srobo-legacy/boards-motor-v4-hw/gerbers/README.txt

Company: Student Robotics
Contact: Rich Barlow
Email:   rbarlow@studentrobotics.org
Phone:   XXXXXXXXXXXX
--------------------------------------------------------------------------------
Board Reference:  mcv4
Board Issue:      b
--------------------------------------------------------------------------------
Board Details:
Bare Board Test:      Yes
Layers:               4
Copper Weight:        1oz (all layers)
Material:             1.6mm FR4
Solder Resist:        BLUE on 2 sides (130 off); RED on 2 sides (30 off)
Silk Screen:          WHITE on 2 sides
Notes:                Please tent vias with solder mask. Please do not pull-back
                      silk from around vias.
--------------------------------------------------------------------------------
Panel Details:
Please panelise as appropriate for in-house assembly. Please position breakout
pips as shown in the drawing 'mcv4b.breakout.png'. When the boards are removed
from the panel it is required that the waste material on the board remains
within the profile of a square corner, as shown in the drawing.
--------------------------------------------------------------------------------
Stack up:
top
group2
group3
bottom
--------------------------------------------------------------------------------
Included Files:

Board:
mcv4b.top.gbr            - Top Copper Layer (Layer 1)
mcv4b.group2.gbr         - First Inner Layer (Layer 2)
mcv4b.group3.gbr         - Second Inner Layer (Layer 3)
mcv4b.bottom.gbr         - Bottom Copper Layer (Layer 4)
mcv4b.topmask.gbr        - Solder Mask Top
mcv4b.bottommask.gbr     - Solder Mask Bottom
mcv4b.toppaste.gbr       - Solder Paste Top
mcv4b.topsilk.gbr        - Silk Screen Top
mcv4b.bottomsilk.gbr     - Silk Screen Bottom
mcv4b.outline.gbr        - Board Outline
mcv4b.plated-drill.cnc   - Plated Hole Drill Information
mcv4b.unplated-drill.cnc - Unplated Hole Drill Information
mcv4b.breakout.png       - Drawing showing positioning of breakout pips

Assembly:
mcv4b.assembly.gbr       - Assembly drawing showing component locations
mcv4b.xy.csv             - XY Placement Data
--------------------------------------------------------------------------------
If there are any problems please contact Rich Barlow using the details at
the top of this file.
