srobo-legacy/boards-motor-v4-hw/gerbers/mcv4b.breakout.png

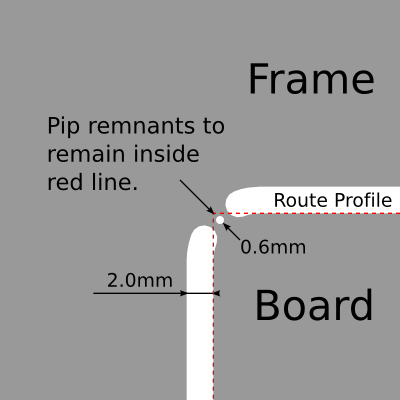
gerbers/mcv4b.breakout.png
