srobo-legacy/boards-motor-v4-hw/bom.xls

Line No. | Internal Part Number | Qty | Value/Description | Package | Distributor | Distributor Order Number | Manufacturer | Manufacturer P/N | Reference Designators
1 | sr-c-100n-0402-16v | 15 | 100n capacitor 0402 16V X7R | 0402 | farnell | 1758896RL | any/open |  | C5, C6, C7, C8, C9, C10, C11, C13, C14, C15, C18, C20, C21, C27, C28
2 | sr-c-100n-0603-50v | 6 | 100n capacitor 0603 50V X7R | 0603 | farnell | 1759122RL | any/open |  | C31, C32, C33, C35, C44, C48
3 | sr-c-10n-0402-25v | 1 | 10n capacitor 0402 25V X7R | 0402 | farnell | 1758924RL | any/open |  | C17
4 | sr-c-10u-1206-16v | 2 | 10u capacitor 1206 16V X7R | 1206 | farnell | 2070502RL | any/open |  | C34, C36
5 | sr-c-1n-0402-50v | 2 | 1n capacitor 0402 50V X7R | 0402 | farnell | 1758991RL | any/open |  | C24, C25
6 | sr-c-1u-0603-16v | 2 | 1u capacitor 0603 16V X7R | 0603 | farnell | 2112839RL | any/open |  | C16, C22
7 | sr-c-220n-0402-16v | 1 | 220n capacitor 0402 16V X5R | 0402 | farnell | 1759389RL | any/open |  | C50
8 | sr-c-22u-0805-6v3 | 2 | 22u capacitor 0805 6.3V X5R | 0805 | farnell | 1867955RL | any/open |  | C4, C52
9 | sr-c-27p-0402-50v | 2 | 27p capacitor 0402 50V C0G/NP0 | 0402 | farnell | 1414584RL | any/open |  | C29, C30
10 | sr-c-2u2-1206-50v | 2 | 2u2 capacitor 1206 50V X7R | 1206 | farnell | 1797017RL | any/open |  | C3, C23
11 | sr-c-33n-0402-25v | 8 | 33n capacitor 0402 25V X7R | 0402 | farnell | 1865445RL | any/open |  | C41, C42, C43, C45, C46, C47, C49, C51
12 | sr-c-470n-0603-25v | 1 | 470n capacitor 0603 25V X7R | 0603 | farnell | 1856365RL | any/open |  | C26
13 | sr-c-47n-0603-50v | 2 | 47n capacitor 0603 50V X7R | 0603 | farnell | 1759116RL | any/open |  | C2, C19
14 | sr-c-4u7-0805-10v | 2 | 4.7u capacitor 0805 10V X7R | 0805 | farnell | 1833814RL | any/open |  | C1, C12
15 | sr-c-pcf1c221mcl1gs | 4 | 220u capacitor smt electrolytic 16V 3.9A ripple | smt_electrolytic_cap | mouser | 647-PCF1C221MCL1GS | Nichicon | PCF1C221MCL1GS | C37, C38, C39, C40
16 | sr-cm-20a-170r | 1 | 20A through-hole cm choke 170R at 100MHz | through_hole | mouser | 875-CM3440Z171B-10 | Laird Technologies | CM3440Z171B-10 | L11
17 | sr-cn-camcon2w | 1 | CTB9550/2 – Pluggable terminal block 2way 7.5mm pitch male horiz | through_hole | farnell | 3882391 | Camden Boss | CTB9550/2 | J5
18 | sr-cn-camcon2w-5mm | 2 | CTB9350/2A – Pluggable terminal block 2way 5mm pitch male horiz | through_hole | farnell | 3882093 | Camden Boss | CTB9350/2A | J6, J7
19 | sr-cn-header2x4-std | 1 | 2x4 through-hole 2.54mm header – 6mm pin length | through_hole | farnell | 1593441 | any/open |  | J2
20 | sr-cn-header2x5-1.27mm | 1 | 2x5 through-hole 1.27mm header – 3mm pin length | through_hole | farnell | 1577743 | any/open |  | J4
21 | sr-cn-minicamcon4w | 1 | CTB93HE/4 – Pluggable terminal block 4way 3.81mm pitch male horiz | through_hole | farnell | 1717073 | Camden Boss | CTB93HE/4 | J3
22 | sr-cn-usb-micro-b | 1 | Micro USB B connector for top mounting | through_hole | digikey | 609-4048-6-ND | FCI | 10103592-0001LF | J1
23 | sr-d-82400102 | 1 | Wurth 82400102 dual TVS diode array | sot23-6 | farnell | 1825875RL | Wurth Elektronik | 82400102 | VR1
24 | sr-d-bat754a | 1 | Schottky diode dual | sot23 | farnell | 1081204RL | NXP | BAT754A | D15
25 | sr-d-bat754c | 2 | schottky diode dual | sot23 | farnell | 1081205RL | NXP | BAT754C | D1, D13
26 | sr-d-bat754s | 5 | schottky diode dual | sot23 | farnell | 1081206RL | NXP | BAT754S | D4, D6, D7, D8, D9
27 | sr-d-bzx384c3v3 | 1 | zener diode 3.3V 5% | sod323 | farnell | 8735646RL | NXP | BZX384-C3V3 | D5
28 | sr-d-gsot05c | 1 | 5V unidirectional dual TVS diode 480W common anode | sot23 | mouser | 78-GSOT05C | Vishay | GSOT05C-GS08 | D10
29 | sr-d-gsot24c | 2 | 24V unidirectional dual TVS diode 325W common anode | sot23 | mouser | 78-GSOT24C | Vishay | GSOT24C-GS08 | D11, D12
30 | sr-d-mmsz4689t1g | 1 | zener diode 5.1V 500mW | sod123 | farnell | 1459121RL | On Semiconductor | MMSZ4689T1G | D2
31 | sr-d-smaj15ca | 1 | 15V bidirectional TVS diode 400W | do-214ac(sma) | farnell | 9802789RL | STMicroelectronics | SMAJ15CA-TR | D3
32 | sr-fb-200m-1k-0402 | 10 | 200mA 1k @ 100MHz 0402 | 0402 | farnell | 1669673RL | any/open |  | L1, L2, L3, L4, L5, L6, L7, L8, L9, L10
33 | sr-fet-n-irfh5301 | 1 | IRFH5301PBF n-channel mosfet 35A | pqfn8 | farnell | 1782047 | International Rectifier | IRFH5301TR2PBF | Q2
34 | sr-fuse-r50-1206 | 1 | 50mA 60V resettable fuse | 1206 | digikey | 507-1476-1-ND | Bel Fuse Inc | 0ZCA0005FF2E | F1
35 | sr-ic-adum3211arz | 1 | ADUM3211ARZ 2.5kV 10Mbps dual bi-directional isolator | soic8 | farnell | 2313635 | Analog Devices | ADUM3211ARZ | U2
36 | sr-ic-ft232rq | 1 | FT232RQ USB to UART | qfn32 | farnell | 1146033RL | FTDI | FT232RQ | U3
37 | sr-ic-lmr14203 | 1 | LMR14203XMK step-down DC/DC converter 42V 0.3A | sot23-6 | farnell | 2064680 | TI | LMR14203XMKE/NOPB | U1
38 | sr-ic-stm32f100r8 | 1 | STM32F100R8 32bit mcu 64k flash 8k ram | lqfp64 | farnell | 1838508 | STMicroelectronics | STM32F100R8T6B | U4
39 | sr-ic-vnh5019 | 2 | VNH5019A-E 30A H-Bridge | power-so30 | verical | VNH5019A-E | STMicroelectronics | VNH5019A-E | U5, U6
40 | sr-l-68u-900ma | 1 | 68u 0.9A smt inductor | smt_inductor | farnell | 2061657 | Bourns | SRN6045-680M | L12
41 | sr-led-blue-0805 | 2 | LED 0805 Blue | 0805 | farnell | 2217974 | Kingbright | KP-2012QBC-D | DS3, DS5
42 | sr-led-green-0805 | 1 | LED 0805 Green | 0805 | farnell | 1318243RL | Kingbright | KP-2012SGC | DS1
43 | sr-led-red-0805 | 3 | LED 0805 Red | 0805 | farnell | 8529949RL | Kingbright | KP-2012EC | DS2, DS4, DS6
44 | sr-led-redblue-dual | 2 | Dual LED Red/Blue | 0805_split | farnell | 1686083RL | Kingbright | KPHBM-2012PBASURKC | DS8, DS9
45 | sr-led-redgreen-0805 | 1 | Bi-Colour LED Red/Green 0805 | 0805 | farnell | 2079908 | Kingbright | KPB-2012SURKCGKC | DS7
46 | sr-npn-bc846b | 2 | BC846B NPN BJT 65V 100mA | sot23 | farnell | 1081229RL | NXP | BC846B | Q1, Q3
47 | sr-r-100-0402 | 1 | 100 0402 chip resistor (63mW) 1% | 0402 | farnell | 2072515 | any/open |  | R17
48 | sr-r-1000k-0402 | 1 | 1M 0402 chip resistor 1% | 0402 | farnell | 2072521 | any/open |  | R9
49 | sr-r-10k | 2 | 10k 0603 chip resistor 1% | 0603 | farnell | 9330399RL | any/open |  | R35, R51
50 | sr-r-10k-0402 | 14 | 10k 0402 chip resistor 1% | 0402 | farnell | 2072517 | any/open |  | R10, R13, R16, R18, R19, R20, R32, R38, R48, R54, R57, R58, R59, R60
51 | sr-r-1k-0402 | 10 | 1k 0402 chip resistor 1% | 0402 | farnell | 2072516 | any/open |  | R27, R28, R30, R31, R36, R43, R44, R46, R47, R52
52 | sr-r-1k-1206 | 3 | 1k 1206 chip resistor 1% | 1206 | farnell | 2073877 | any/open |  | R21, R37, R53
53 | sr-r-1k1-0402 | 7 | 1k1 0402 chip resistor 1% | 0402 | farnell | 2072548 | any/open |  | R23, R26, R34, R39, R42, R50, R55
54 | sr-r-330-0402 | 6 | 330 0402 chip resistor 1% | 0402 | farnell | 2072927 | any/open |  | R1, R4, R6, R7, R8, R12
55 | sr-r-33k2-0402 | 1 | 33k2 0402 chip resistor 1% | 0402 | farnell | 2072936 | any/open |  | R56
56 | sr-r-4k3-0402 | 5 | 4k3 0402 chip resistor 1% | 0402 | farnell | 2073030 | any/open |  | R22, R25, R33, R41, R49
57 | sr-r-4k7-0402 | 7 | 4k7 0402 chip resistor 1% | 0402 | farnell | 2073064 | any/open |  | R5, R14, R15, R24, R29, R40, R45
58 | sr-sw-button-ra | 1 | FSMRA2JH Right angle tactile button | through_hole | farnell | 1555987 | TE Connectivity | FSMRA2JH | S1
59 | sr-xtal-abmm2-8.000mhz-e2-t | 1 | 8MHz Crystal 20ppm | smt_crystal | farnell | 1611803RL | ABRACON | ABMM2-8.000MHZ-E2-T | Y1
