srobo-legacy/boards-motor-v4-hw/case.dxf

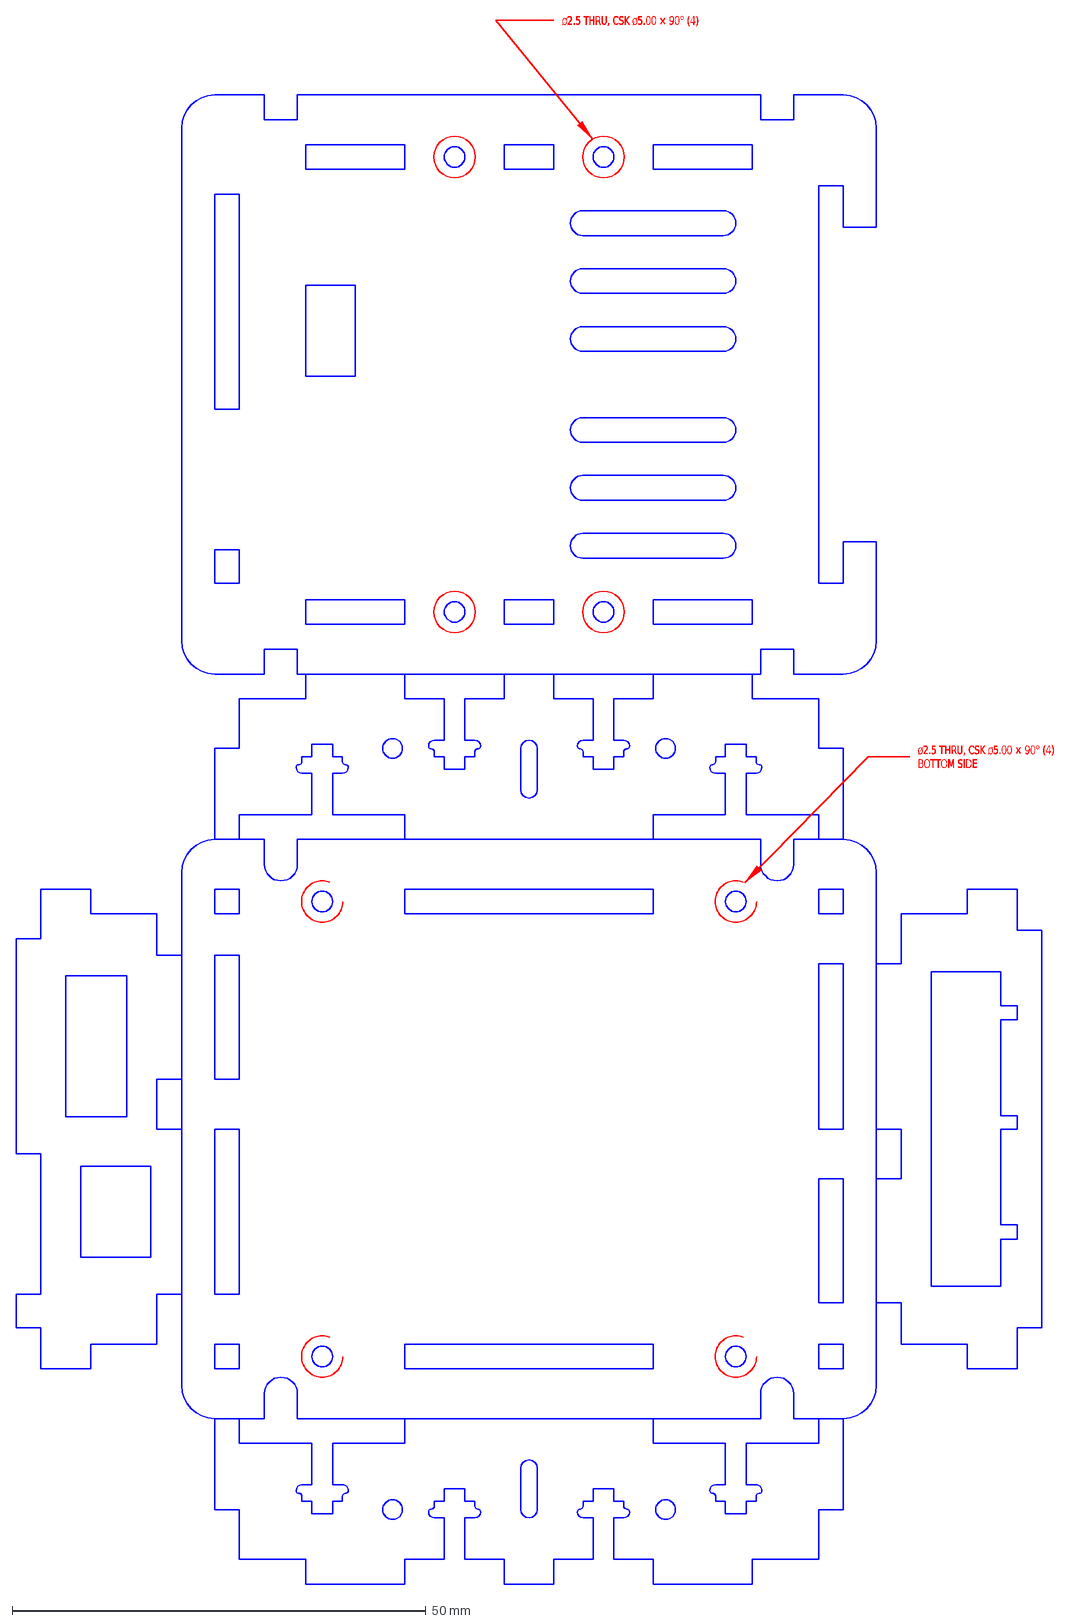
[picture p2: CAD file, 2013-08-05]
case.dxf
ø2.5\~THRU,\~CSK\~ø5.00\~×\~90°\~(4) BOTTOM\~SIDE
ø2.5\~THRU,\~CSK\~ø5.00\~×\~90°\~(4)
