srobo-legacy/boards-motor-v4-hw/(list of files, drawings)

Other design files:
motor.pcb
pcb_silk/silk.pcb
