srobo-legacy/boards-motor-v4-hw/(commit log)

2013-02-03 Begin the development of the USB motor board
    [motor-logic.sch]
2013-02-03 Add a title and 'power' schematic
    [motor-power.sch, motor-title.sch]
2013-02-03 Add makefile to generate pdf/bom
    This is the same makefile as used by the previous motor board design,
    however it's had the gsch2pcb stuff removed as I'm going to use the PCB
    'import' feature to forward annotate.
2013-02-04 Add block diagram to schematic
    [motor-title.sch]
2013-02-04 Shift the schematic titles
    The word 'Power' was overlapping the border when exported.
    [motor-logic.sch, motor-power.sch, motor-title.sch]
2013-02-17 Draw most of the interface side
    [motor-logic.sch]
2013-02-18 Correct values of UART filter caps
    [motor-logic.sch]
2013-02-18 Add a load of test points to the interface side
    [motor-logic.sch]
2013-02-19 Add filter cap to FT232 reset pin
    [motor-logic.sch]
2013-02-19 Shuffle things around, no electrical change
    [motor-logic.sch]
2013-02-19 Add zener diode to IFACE_VCC rail
    [motor-logic.sch]
2013-02-19 Add note about USB data line routing
    [motor-logic.sch]
2013-02-19 Add JTAG connector
    [motor-logic.sch]
2013-02-19 Add STM32 crystal
    [motor-logic.sch]
2013-02-21 Add 3V3 reg
    [motor-logic.sch]
2013-02-22 Add cap and test point to uC reset line
    [motor-logic.sch]
2013-02-26 Add boot/reset button circuit
    Pressing this button puts the uC into its ROM bootloader, allowing a
    brand-new or 'bricked' board to be flashed over its UART.
    The circuit pulls the BOOT0 line high and sends a 1ms reset pulse to the
    uC.
    [motor-logic.sch]
2013-02-27 Correct BOOT/nRESET circuit
    The output of the circuit was wired up to BOOT0 instead of nRESET as it
    should have been. BOOT0 is taken directly from the button.
    [motor-logic.sch]
2013-02-27 Add graphical representaton of the isolation barrier
    [motor-logic.sch]
2013-02-27 Connect up uC UART to isolator
    [motor-logic.sch]
2013-02-28 Draw a big chunk of the power schematic
    [motor-power.sch]
2013-02-28 Add most of the interface circuitry between the uC and H-Bridges
    [motor-logic.sch, motor-power.sch]
2013-03-01 Add current sense filters
    [motor-power.sch]
2013-03-01 Add output voltage feedback dividers
    [motor-power.sch]
2013-03-01 Add clamping diodes to the voltage feedback lines
    [motor-power.sch]
2013-03-01 Shuffle some things about, no electrical change
    [motor-power.sch]
2013-03-01 Add 12V sense divider
    [motor-power.sch]
2013-03-01 Add direction/power LEDs to the outputs
    [motor-power.sch]
2013-03-01 Add power side power LED
    [motor-power.sch]
2013-03-01 Add some filtering to the outputs
    The resistor ensures there's always a small amount of load even with no
    motor connected. The cap provides a small amount of differential
    filtering.
    [motor-power.sch]
2013-03-01 Add TVS diode to the main power input
    [motor-power.sch]
2013-03-01 Add an LED to indicate incorrect power polarity
    [motor-power.sch]
2013-03-01 Add isolation bypass resistors
    [motor-logic.sch]
2013-03-01 Add loads of test points
    [motor-logic.sch, motor-power.sch]
2013-03-02 Wire up H-bridges to uC
    [motor-logic.sch]
2013-03-02 Add four controllable LEDs
    [motor-logic.sch]
2013-03-03 Add expansion header
    [motor-logic.sch]
2013-03-03 Swap expansion header symbol for a double-sided variant
    This makes it more clear how the signals are laid out. I've also
    rearranged the signals so that the ground pin shields the signal lines
    from the potentially noisy 12V line.
    [motor-logic.sch]
2013-03-03 Add some filtering to the expansion header power lines
    [motor-logic.sch]
2013-03-03 Assign actual SR part codes to all the 100n caps
    [motor-logic.sch, motor-power.sch]
2013-03-03 Add values to the 1uF caps
    [motor-logic.sch]
2013-03-03 Add values to 10uF caps
    [motor-logic.sch, motor-power.sch]
2013-03-03 Add values to the 33nF caps
    [motor-power.sch]
2013-03-03 Assign values to the 4.7uF caps
    [motor-logic.sch]
2013-03-03 Assign values to the 10nF and 1nF caps
    [motor-logic.sch]
2013-03-03 Add value to USB shield cap
    [motor-logic.sch]
2013-03-03 Add value to 470nF cap
    [motor-logic.sch]
2013-03-03 Add values to main bulk decoupling caps
    [motor-power.sch]
2013-03-03 Add value to common mode choke
    [motor-power.sch]
2013-03-03 Add value to crystal and crystal loading caps
    [motor-logic.sch]
2013-03-05 Add values to the FT232 and the isolator
    [motor-logic.sch]
2013-03-05 Add value to STM32
    [motor-logic.sch]
2013-03-05 Add values to H-Bridges
    [motor-power.sch]
2013-03-05 Add value to 3V3 reg
    [motor-logic.sch]
2013-03-05 Add value to USB protection device
    [motor-logic.sch]
2013-03-05 Add value to reverse polarity protection fet
    [motor-power.sch]
2013-03-05 Assign values to the off-board connectors
    [motor-logic.sch, motor-power.sch]
2013-03-05 Add value to reset BJT
    [motor-logic.sch]
2013-03-05 Add value to reset/boot button
    [motor-logic.sch]
2013-03-06 Add values to all resistors
    Values that don't have a chip size in them are 0603
    [motor-logic.sch, motor-power.sch]
2013-03-07 Assign values to dual diodes
    [motor-logic.sch, motor-power.sch]
2013-03-07 Add values to ferrite beads
    [motor-logic.sch]
2013-03-07 Add value to zener diode
    [motor-logic.sch]
2013-03-07 Add values to JTAG and EXP headers
    [motor-logic.sch]
2013-03-07 Add value to polyfuse
    [motor-logic.sch]
2013-03-07 Add value to main TVS diode
    [motor-power.sch]
2013-03-07 Add values to LEDs
    [motor-logic.sch, motor-power.sch]
2013-03-07 Add 3V3 zener to 3V3 rail
    There are quite a few clamping diodes that clamp to the 3V3 rail. The
    zener is there to ensure that there's somewhere for the clamped energy
    to go.
    [motor-power.sch]
2013-03-08 Assign reference designators
    [motor-logic.sch, motor-power.sch]
2013-03-08 Set value of test points and make values lower case
    [motor-logic.sch, motor-power.sch]
2013-03-08 Remove two superfluous test points
    [motor-logic.sch, motor-power.sch]
2013-03-13 Add more notes to the schematic
    [motor-logic.sch, motor-power.sch]
2013-04-06 Add TVS diodes to all external non-power connections
    These are the terminals which are going to experience ESD. The power
    line on the serial connector is already protected by the zener on the
    interface power rail. The main power connector already has a
    bidirectional TVS diode on it.
    [motor-logic.sch, motor-power.sch]
2013-04-07 Change linear 3V3 reg to SMPS
    The LDO would have always run warm and it wouldn't be able to handle 24V
    operation. The SMPS solution is ~80p more, can handle 24V operation and
    can output up to 200mA.
    [motor-logic.sch]
2013-04-07 Increase the voltage rating of a few caps
    To make supporting 24V easier - these caps won't need swapping.
    [motor-logic.sch]
2013-04-07 Change some 1k resistors to 1206
    These resistors need to dissipate a fair bit of power. The 2k2 resistors
    that'll go into their place for 24V operation will need to dissipate
    even more.
    [motor-power.sch]
2013-04-07 Add a table outlining what components to use for 24V
    [motor-title.sch]
2013-04-07 Update comment about isolation bridge components
    Also add a dummy diode to remove the need to power the interface side
    when not using isolation and using the serial interface.
    [motor-logic.sch]
2013-04-09 Add some stuff to protect against 24V reverse polarity
    The charge pump section of the VNH5019 can only handle -16V, so would be
    destroyed by -24V applied to the board. The new bit of circuitry ensures
    that the reverse polarity FET is off when reverse polarity is applied,
    while ensuring that no negative voltage is applied to the VNH5019 charge
    pump at all.
    [motor-power.sch]
2013-04-09 Add some test points to the reverse polarity stuff
    [motor-power.sch]
2013-04-09 More resistors to change for 24V
    The output voltage measurement potential divider resistors also need to
    change value for 24V operation.
    [motor-title.sch]
2013-04-20 Add footprint 'pkg' submodule
2013-04-27 Update schematic for modified crystal symbol
    The crystal has four pins, two of them are the can and should be
    connected to ground.
    [motor-logic.sch]
2013-05-04 Remove superfluous diode
    The body diode in the reverse polarity protection FET (Q2) already
    performs the function of the removed diode. The diode was only there to
    provide power to the VBATT pins of the VNH5019s. We don't actually need
    the functionality of the VBATT pins any more (their function is to
    handle large negative voltages without damage). To ensure we're
    operating the VNH5019s within spec the VBATT pins should still be
    powered, but there should be no problem just powering them from the same
    rail as the VCC lines.
    [motor-power.sch]
2013-05-06 Assign footprints to all components
    [motor-logic.sch, motor-power.sch]
2013-05-06 Correct a few footprint errors and add test point fp
    [motor-logic.sch, motor-power.sch]
2013-05-06 Add pcb settings file to force package search path
2013-05-11 Add PCB layout file, with configured DRC and layers
    [motor.pcb]
2013-05-12 Place the power stuff and the USB stuff
    [motor.pcb]
2013-05-12 Correct net names on inter-sheet symbols
    [motor-power.sch]
2013-05-12 Swap status LED/resistors around
    The traces to these LEDs are going to be running near the power stuff.
    So it makes more sense for the potentially noisey lines to be connected
    to the uC through the resistors.
    [motor-logic.sch]
2013-05-12 Finish placing components on PCB layout
    [motor.pcb]
2013-05-12 Reduce the PCB canvas size
    [motor.pcb]
2013-05-12 Remove the footprint name from the description field
    PCB doesn't have the ability to not output a bit of text for each
    footprint while still outputting the rest of the silk. It does allow you
    to select between three different things, so I've set one of these to be
    empty for all footprints and told it to output that.
    The board is too dense to fit the reference designators in. I will place
    them in the middle of the components for as assembly aid.
    [motor.pcb]
2013-05-12 Revert "Remove the footprint name from the description field"
    Turns out this breaks the import schematics things quite
    catastrophically. It uses the 'description' field to track where each
    instantiated footprint came from. This is fair enough, but it shouldn't
    segfault when there's an empty description ;) I'll have to find another
    solution for not showing any text later on.
    This reverts commit 5a5fa36101c22009639dc5acd1d13cc55bf431a4.
    [motor.pcb]
2013-05-12 Swap the output pins around
    So that they align on the layout
    [motor-power.sch, motor.pcb]
2013-05-12 Shuffle some bits and bobs around
    [motor.pcb]
2013-05-12 Alter how the isolation bypass is performed
    This is quite horrible and hacky at the moment, but the bypass pads are
    included in the SOIC8 footprint itself. This means that the symbols
    shown on the schematic are not functional and do not have footprints in
    the layout. Unfortunately I can't find a way of telling PCB this, so
    I've just disconnected them in the schematic for now.
    [motor-logic.sch, motor.pcb]
2013-05-13 Route the main power traces
    [motor.pcb]
2013-05-18 Swap USB TVS diode array
    The previous one was just too small. This one is more sane and possibly
    cheaper if bought direct from Wurth.
    [motor-logic.sch]
2013-05-19 Routing
    Swap the MISO/MOSI lines around on the expansion header to make routing
    easier.
    [motor-logic.sch, motor.pcb]
2013-05-20 Routing (Finished!)
    [motor.pcb]
2013-05-20 Add another GND test point
    This one is right next to the microcontroller analogue ground pin
    [motor-logic.sch, motor.pcb]
2013-05-20 Change most 0.25mm traces to 0.2mm
    [motor.pcb]
2013-05-20 Add interface GND plane to bottom layer
    [motor.pcb]
2013-05-20 Add ground plane on bottom layer
    [motor.pcb]
2013-05-20 Position refdeses
    [motor.pcb]
2013-05-21 Produce red photo-realistic PCB images
    Also exclude the reference designators from the top layer.
2013-05-24 Move some traces in from the edge
    [motor.pcb]
2013-05-24 Increase the annular ring around some pins
    [motor.pcb]
2013-05-26 Add some fancy silk to the bottom side
    [motor.pcb, silk.pcb]
2013-05-26 Add some more interface labels
    Also moved some test point identifiers away from a mounting hole.
    [motor.pcb]
2013-05-27 Remove 'both' photo pcb png in make clean target
2013-05-27 Add Rev A gerbers
    [motor-v4a.bottom.gbr, motor-v4a.bottommask.gbr, motor-v4a.bottomsilk.gbr, motor-v4a.fab.gbr, motor-v4a.inner1.gbr, motor-v4a.inner2.gbr, motor-v4a.outline.gbr, motor-v4a.top.gbr]
2013-06-10 Correct position of R29/R30 refdes on PCB layout
    These were the wrong way around.
    [motor.pcb]
2013-06-21 Allow some random changes by PCB
    For some reason PCB wants to change some units in the file even though
    I've not changed anything in the layout. The layout is identical to the
    previous commit.
    [motor.pcb]
2013-06-21 Flip the main power LED
    It was backwards. I want green to be normal and red to indicate a
    problem.
    [motor-power.sch, motor.pcb]
2013-06-21 Shuffle traces around the push button
    A couple of traces underneath the push button were a little too close
    for comfort to the metal frame where it touches the PCB.
    [motor.pcb]
2013-06-27 Switch to a bigger uC
    The R6 and R8 are pin compatible. The R8 has 64k of flash and 8k of RAM.
    The main reason for switching is that the R8 has TIM4, which means that
    both TIM3 and TIM4 will be exposed on the expansion header. This will
    allow for really easy quadrature encoder based feedback for both
    channels. Even if we don't take advantage of this straight away, it'll
    be really annoying in the future if we can't do it because of a weedy
    micro.
    [motor-logic.sch]
2013-06-27 Correct the uC value on the power symbol
    [motor-logic.sch]
2013-06-27 Add assembler compatible BOM
    [bom.xls]
2013-06-29 Update distributors for out of stock components
    [bom.xls]
2013-06-29 Modify board silk for Rev B
    [motor.pcb, silk.pcb]
2013-06-29 Add Rev B gerbers
    [mcv4b.assembly.gbr, mcv4b.bottom.gbr, mcv4b.bottommask.gbr, mcv4b.bottomsilk.gbr, mcv4b.group2.gbr, mcv4b.group3.gbr, mcv4b.outline.gbr, mcv4b.top.gbr]
2013-06-29 Add revision letter to schematics
    [motor-logic.sch, motor-power.sch, motor-title.sch]
2013-06-30 Rename the placement CSV to prevent windows confusion
    Windows probably won't like a '.xy' file. Also remove the # comments
    from the top of the file and use mm instead of mils.
    [mcv4b.xy.csv]
2013-07-13 Begin the case design
    [case.dxf]
2013-07-13 Finish case design
    [case.dxf]
2013-07-14 Change case line colour and thickness
    Razorlab needs lines to be very thin (for unknown reasons) and blue
    lines are used to indicate cut lines.
    [case.dxf]
2013-07-14 case: Fix the size/position of the screw holes
    These were all slightly the wrong diameter and positioned in weird
    off-grid positions.
    [case.dxf]
2013-07-14 case: Add layer showing countersink on screw holes
    [case.dxf]
2013-07-15 Update the BOM with the final suppliers
    Farnell now sell more things, and they're cheaper than elsewhere. Also
    less Digikey, which is always a good thing.
    [bom.xls]
2013-07-30 Remove 'Notes' column from the BOM
    [bom.xls]
2013-08-05 Add camcon plug notches to case design
    [case.dxf]
2013-12-27 Correct file names in schematic title blocks
    [motor-power.sch, motor-title.sch]
